denjhang/My4TH-light/README.md

# My4TH light
 My4TH light is the big brother of the My4TH XS computer board. In contrast to the My4TH XS it has an I2C interface that is 8 times faster than the I2C interface of the original My4TH board.   
 Originated from: http://mynor.org/my4th_xs.htm
