denjhang/My4TH-light/schematics_my4th-light_v1.2.pdf

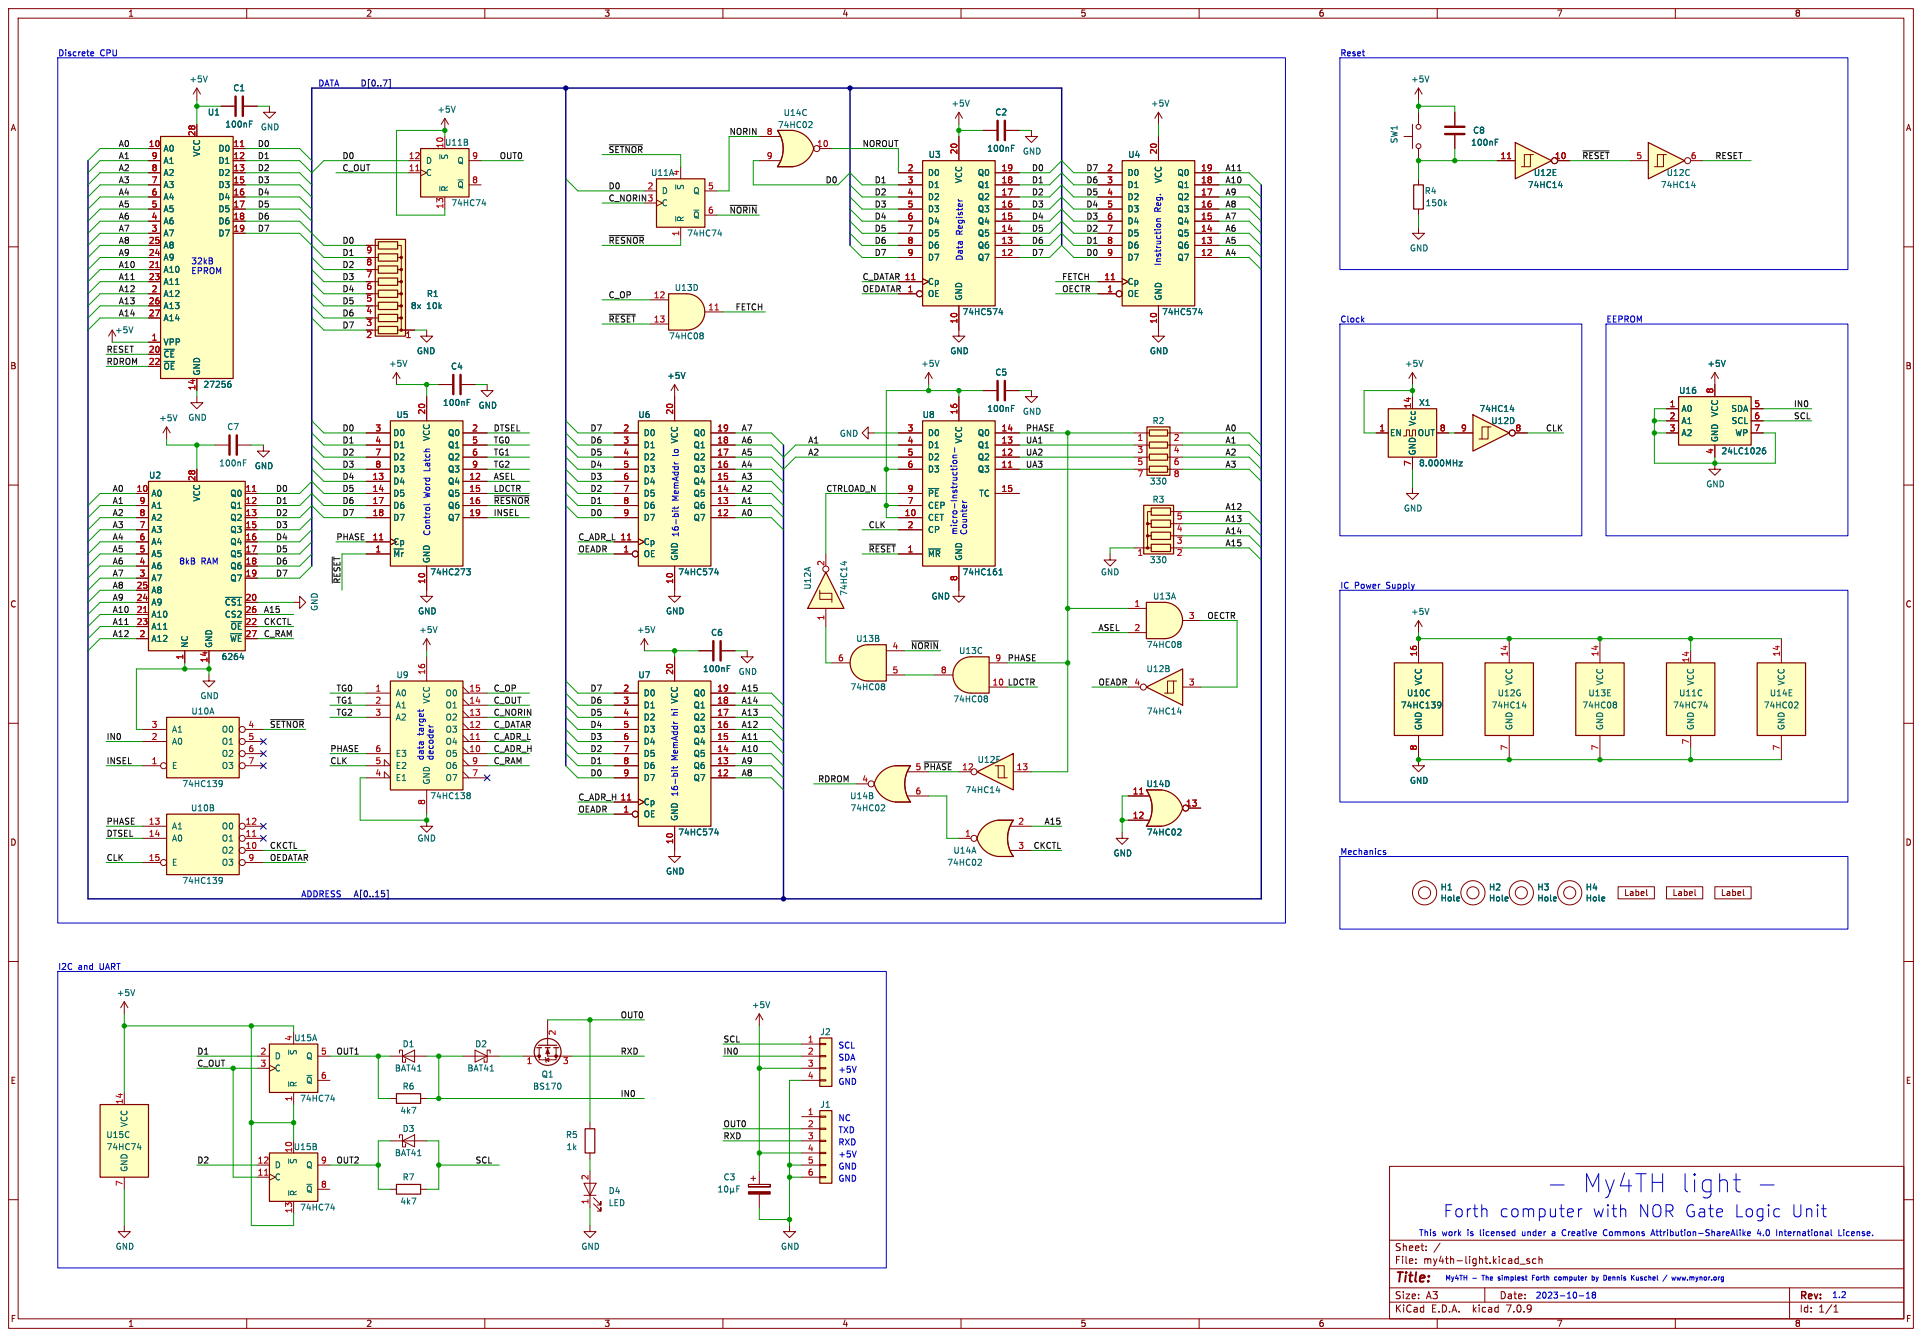
[picture p24: page 1]

D3 16-bit MemAddr hi
1.2 Data Register SCL 16-bit MemAddr lo

IC Power Supply 8kB RAM

Id: 1/1 Title: File: my4th-light.kicad_sch Sheet: /
