denjhang/My4TH-light/kicad_my4th-light_v1.2/kicad_my4th-light_v1.2/my4th-light.kicad_pcb

## KiCad design kicad_my4th-light_v1.2/kicad_my4th-light_v1.2/my4th-light.kicad_pcb (2024-05-02)

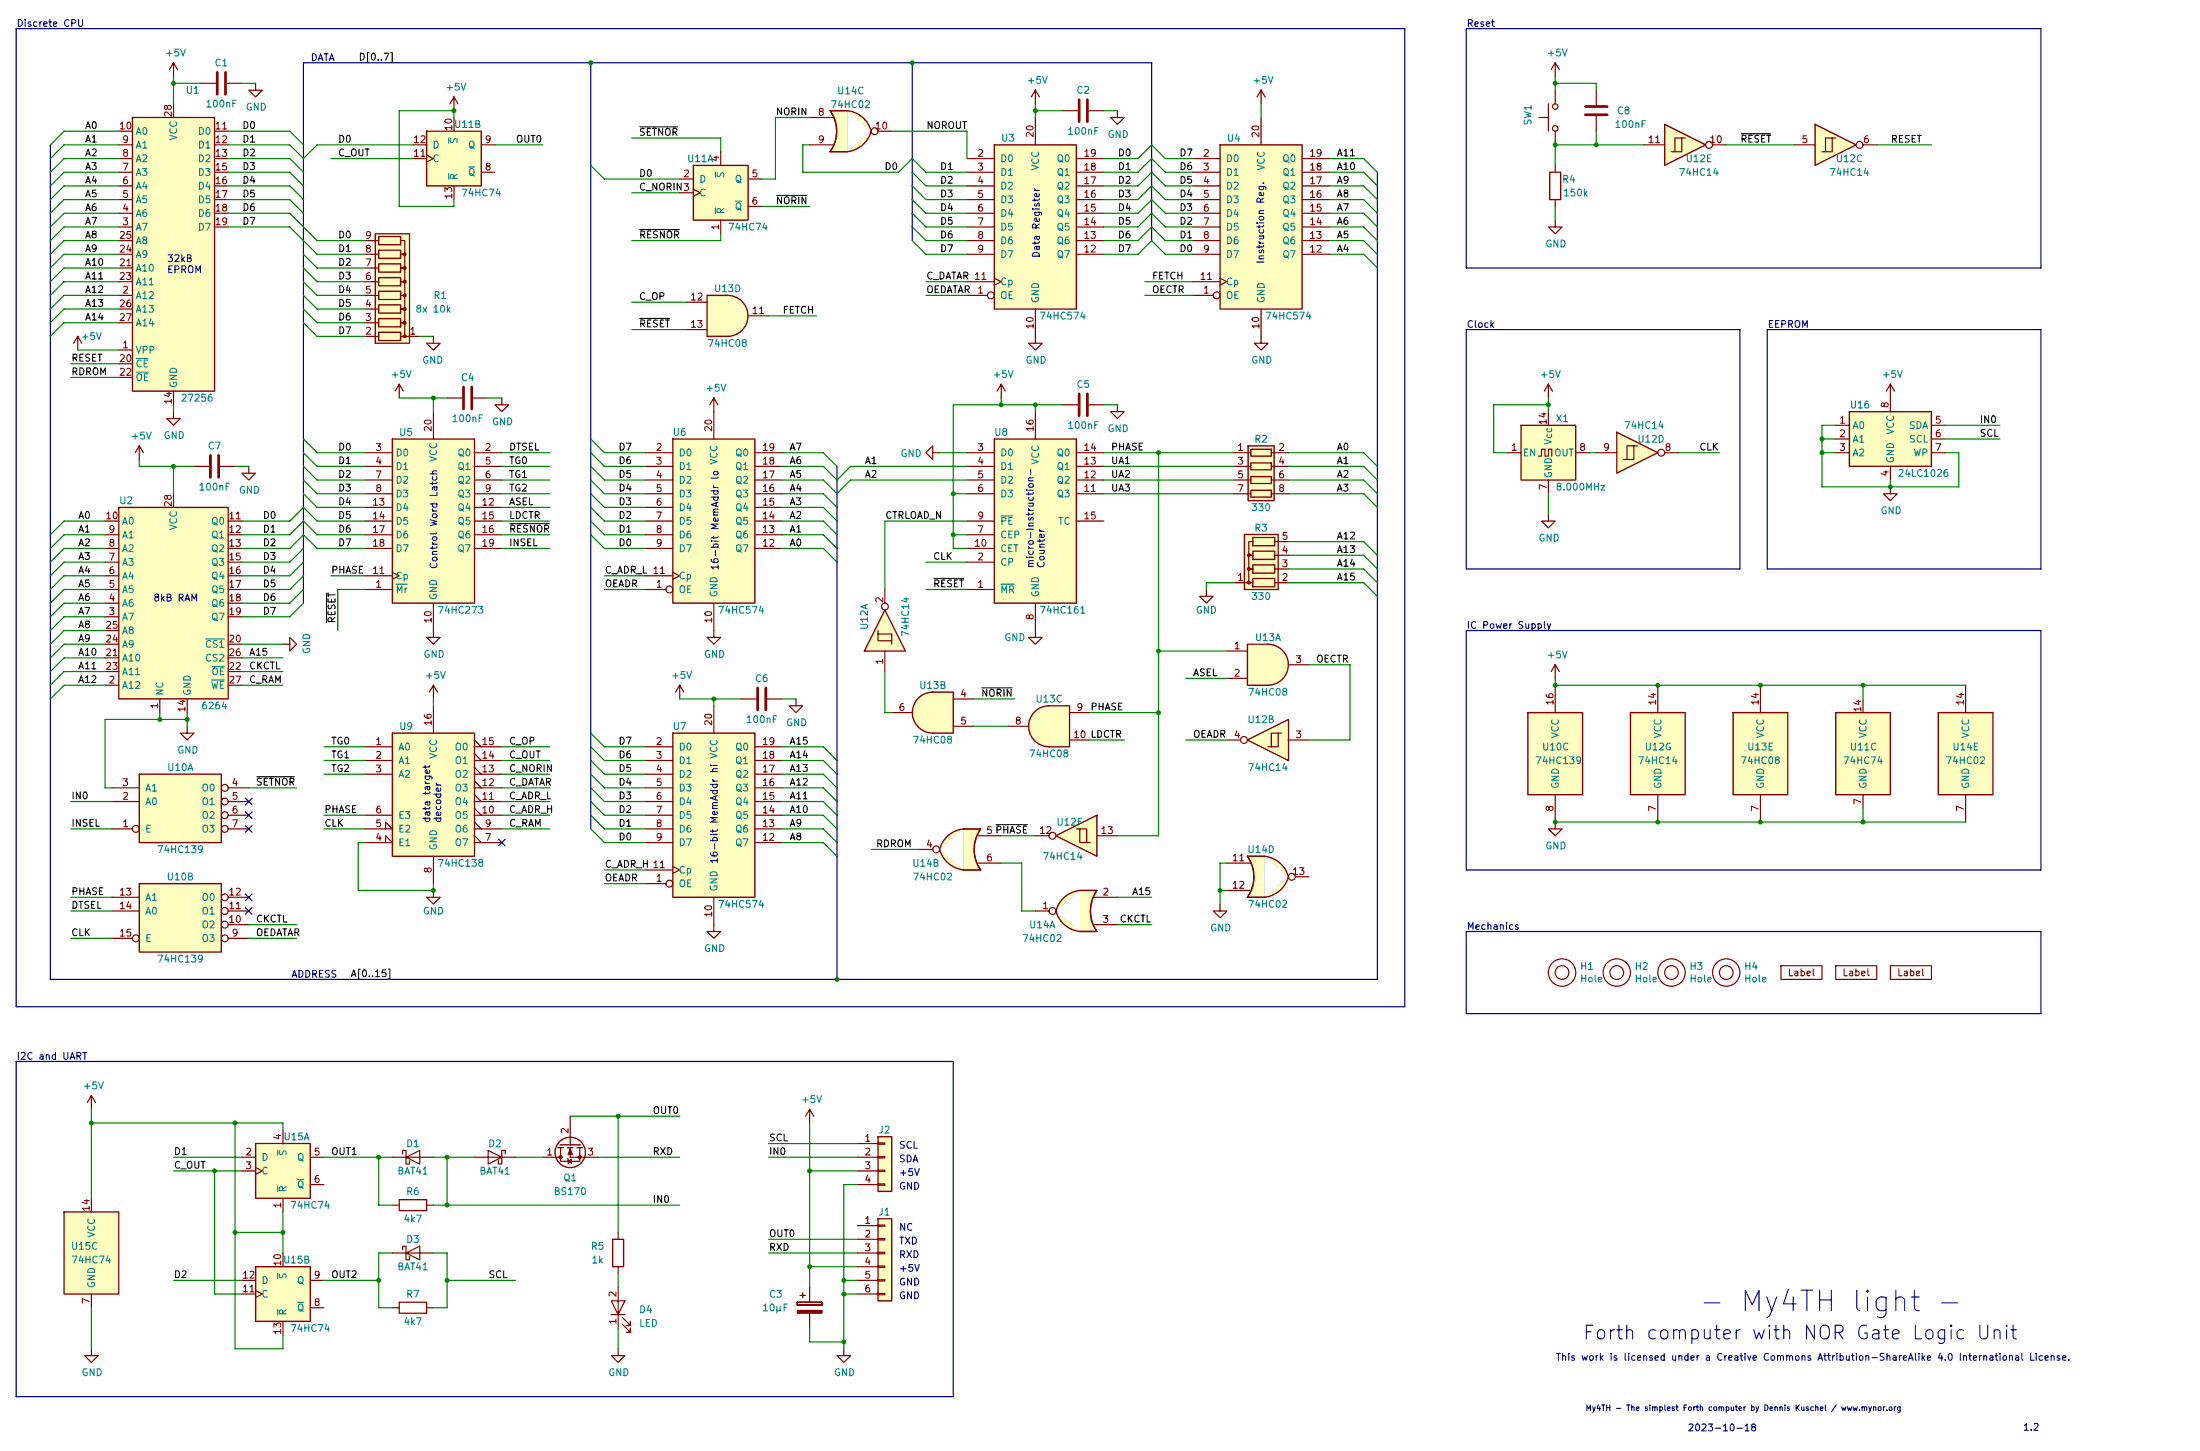
[picture p25: schematic my4th-light.kicad_sch]

Parts:
C1, C2, C4, C5, C6, C7, C8: 100nF; C_Disc_D5.0mm_W2.5mm_P5.00mm
C3: 10µF; CP_Radial_D5.0mm_P2.00mm
D1, D2, D3: BAT41; D_DO-35_SOD27_P7.62mm_Horizontal
D4: LED; LED_D3.0mm
H1, H2, H3, H4: Hole; nonplated_hole_drill_2.6mm_dia_5.2mm
J1: Conn_01x06; Pin_Header_Angled_1x06_Pitch2.54mm
J2: Conn_01x04; Pin_Header_Angled_1x04_Pitch2.54mm
LB1: Label; MyNOR-Logo-2
LB2: Label; cc-by-sa
LB3: Label; img-my4th
Q1: BS170; TO-92_Inline_Wide
R1: 8x 10k; R_Array_SIP9
R2: 330; R_Array_SIP8
R3: 330; R_Array_SIP5
R4: 150k; R_Axial_DIN0207_L6.3mm_D2.5mm_P7.62mm_Horizontal
R5: 1k; R_Axial_DIN0207_L6.3mm_D2.5mm_P7.62mm_Horizontal
R6, R7: 4k7; R_Axial_DIN0207_L6.3mm_D2.5mm_P7.62mm_Horizontal
SW1: SW_Push; SW_PUSH_6mm_h4.3mm
U1: 27256; DIP-28_W15.24mm_Socket
U2: 6264; DIP-28_W15.24mm
U3, U4, U6, U7: 74HC574; DIP-20_W7.62mm
U5: 74HC273; DIP-20_W7.62mm
U8: 74HC161; DIP-16_W7.62mm
U9: 74HC138; DIP-16_W7.62mm
U10: 74HC139; DIP-16_W7.62mm
U11, U15: 74HC74; DIP-14_W7.62mm
U12: 74HC14; DIP-14_W7.62mm
U13: 74HC08; DIP-14_W7.62mm
U14: 74HC02; DIP-14_W7.62mm
U16: 24LC1026; DIP-8_W7.62mm
X1: 8.000MHz; Osc_DIP8_DIP14_LargePads

Connections:
+5V: C1.2, C2.2, C3.1, C4.2, C5.2, C6.2, C7.2, C8.2, J1.4, J2.3, SW1.2, U1.1 (VPP), U1.28 (VCC), U2.28 (VCC), U3.20 (VCC), U4.20 (VCC), U5.20 (VCC), U6.20 (VCC), U7.20 (VCC), U8.6 (D3), U8.7 (CEP), U8.10 (CET), U8.16 (VCC), U9.16 (VCC), U10.16 (VCC), U11.10 (~S), U11.13 (~R), U11.14 (VCC), U12.14 (VCC), U13.14 (VCC), U14.14 (VCC), U15.1 (~R), U15.4 (~S), U15.10 (~S), U15.13 (~R), U15.14 (VCC), U16.8 (VCC), X1.1 (EN), X1.14 (Vcc)
/A0: R2.2 (R1.2), U1.10 (A0), U2.10 (A0), U6.12 (Q7)
/A1: R2.4 (R2.2), U1.9 (A1), U2.9 (A1), U6.13 (Q6), U8.4 (D1)
/A2: R2.6 (R3.2), U1.8 (A2), U2.8 (A2), U6.14 (Q5), U8.5 (D2)
/A3: R2.8 (R4.2), U1.7 (A3), U2.7 (A3), U6.15 (Q4)
/A4: U1.6 (A4), U2.6 (A4), U4.12 (Q7), U6.16 (Q3)
/A5: U1.5 (A5), U2.5 (A5), U4.13 (Q6), U6.17 (Q2)
/A6: U1.4 (A6), U2.4 (A6), U4.14 (Q5), U6.18 (Q1)
/A7: U1.3 (A7), U2.3 (A7), U4.15 (Q4), U6.19 (Q0)
/A8: U1.25 (A8), U2.25 (A8), U4.16 (Q3), U7.12 (Q7)
/A9: U1.24 (A9), U2.24 (A9), U4.17 (Q2), U7.13 (Q6)
/A10: U1.21 (A10), U2.21 (A10), U4.18 (Q1), U7.14 (Q5)
/A11: U1.23 (A11), U2.23 (A11), U4.19 (Q0), U7.15 (Q4)
/A12: R3.5 (R4), U1.2 (A12), U2.2 (A12), U7.16 (Q3)
/A13: R3.4 (R3), U1.26 (A13), U7.17 (Q2)
/A14: R3.3 (R2), U1.27 (A14), U7.18 (Q1)
/A15: R3.2 (R1), U2.26 (CS2), U7.19 (Q0), U14.2
/ASEL: U5.12 (Q4), U13.2
/CKCTL: U2.22 (~OE), U10.10 (O2), U14.3
/CLK: U8.2 (CP), U9.5 (E2), U10.15 (E), U12.8
/CTRLOAD_N: U8.9 (~PE), U12.2
/C_ADR_H: U7.11 (Cp), U9.10 (O5)
/C_ADR_L: U6.11 (Cp), U9.11 (O4)
/C_DATAR: U3.11 (Cp), U9.12 (O3)
/C_NORIN: U9.13 (O2), U11.3 (C)
/C_OP: U9.15 (O0), U13.12
/C_OUT: U9.14 (O1), U11.11 (C), U15.3 (C), U15.11 (C)
/C_RAM: U2.27 (~WE), U9.9 (O6)
/D0: R1.9 (R8), U1.11 (D0), U2.11 (Q0), U3.19 (Q0), U4.9 (D7), U5.3 (D0), U6.9 (D7), U7.9 (D7), U11.2 (D), U11.12 (D), U14.9
/D1: R1.8 (R7), U1.12 (D1), U2.12 (Q1), U3.3 (D1), U3.18 (Q1), U4.8 (D6), U5.4 (D1), U6.8 (D6), U7.8 (D6), U15.2 (D)
/D2: R1.7 (R6), U1.13 (D2), U2.13 (Q2), U3.4 (D2), U3.17 (Q2), U4.7 (D5), U5.7 (D2), U6.7 (D5), U7.7 (D5), U15.12 (D)
/D3: R1.6 (R5), U1.15 (D3), U2.15 (Q3), U3.5 (D3), U3.16 (Q3), U4.6 (D4), U5.8 (D3), U6.6 (D4), U7.6 (D4)
/D4: R1.5 (R4), U1.16 (D4), U2.16 (Q4), U3.6 (D4), U3.15 (Q4), U4.5 (D3), U5.13 (D4), U6.5 (D3), U7.5 (D3)
/D5: R1.4 (R3), U1.17 (D5), U2.17 (Q5), U3.7 (D5), U3.14 (Q5), U4.4 (D2), U5.14 (D5), U6.4 (D2), U7.4 (D2)
/D6: R1.3 (R2), U1.18 (D6), U2.18 (Q6), U3.8 (D6), U3.13 (Q6), U4.3 (D1), U5.17 (D6), U6.3 (D1), U7.3 (D1)
/D7: R1.2 (R1), U1.19 (D7), U2.19 (Q7), U3.9 (D7), U3.12 (Q7), U4.2 (D0), U5.18 (D7), U6.2 (D0), U7.2 (D0)
/DTSEL: U5.2 (Q0), U10.14 (A0)
/FETCH: U4.11 (Cp), U13.11
/IN0: D1.2 (A), D2.2 (A), J2.2, R6.2, U10.2 (A0), U16.5 (SDA)
/INSEL: U5.19 (Q7), U10.1 (E)
/LDCTR: U5.15 (Q5), U13.10
/NORIN: U11.5 (Q), U14.8
/NOROUT: U3.2 (D0), U14.10
/OEADR: U6.1 (OE), U7.1 (OE), U12.4
/OECTR: U4.1 (OE), U12.3, U13.3
/OEDATAR: U3.1 (OE), U10.9 (O3)
/OUT0: J1.2, Q1.2 (G), R5.1, U11.9 (Q)
/OUT1: D1.1 (K), R6.1, U15.5 (Q)
/OUT2: D3.1 (K), R7.1, U15.9 (Q)
/PHASE: R2.1 (R1.1), U5.11 (Cp), U8.14 (Q0), U9.6 (E3), U10.13 (A1), U12.13, U13.1, U13.9
/RDROM: U1.22 (~OE), U14.4
/RESET: U1.20 (~CE), U12.6
/RXD: J1.3, Q1.3 (S)
/SCL: D3.2 (A), J2.1, R7.2, U16.6 (SCL)
/TG0: U5.5 (Q1), U9.1 (A0)
/TG1: U5.6 (Q2), U9.2 (A1)
/TG2: U5.9 (Q3), U9.3 (A2)
/UA1: R2.3 (R2.1), U8.13 (Q1)
/UA2: R2.5 (R3.1), U8.12 (Q2)
/UA3: R2.7 (R4.1), U8.11 (Q3)
/~NORIN: U11.6 (~Q), U13.4
/~PHASE: U12.12, U14.5
/~RESET: U5.1 (~Mr), U8.1 (~MR), U12.5, U12.10, U13.13
/~RESNOR: U5.16 (Q6), U11.1 (~R)
/~SETNOR: U10.4 (O0), U11.4 (~S)
GND: C1.1, C2.1, C3.2, C4.1, C5.1, C6.1, C7.1, D4.1 (K), J1.5, J1.6, J2.4, R1.1 (common), R3.1 (common), R4.2, U1.14 (GND), U2.1 (NC), U2.14 (GND), U2.20 (~CS1), U3.10 (GND), U4.10 (GND), U5.10 (GND), U6.10 (GND), U7.10 (GND), U8.3 (D0), U8.8 (GND), U9.4 (E1), U9.8 (GND), U10.3 (A1), U10.8 (GND), U11.7 (GND), U12.7 (GND), U13.7 (GND), U14.7 (GND), U14.11, U14.12, U15.7 (GND), U16.1 (A0), U16.2 (A1), U16.3 (A2), U16.4 (GND), U16.7 (WP), X1.7 (GND)
unnamed: C8.1, R4.1, SW1.1, U12.11
unnamed: D2.1 (K), Q1.1 (D)
unnamed: D4.2 (A), R5.2
unnamed: U12.1, U13.6
unnamed: U13.5, U13.8
unnamed: U14.1, U14.6
unnamed: U12.9, X1.8 (OUT)

Notes on the sheet:
Clock
EEPROM
SDA
Reset
Discrete CPU
data target decoder
DATA
+5V
My4TH - The simplest Forth computer by Dennis Kuschel / www.mynor.org
GND
RXD
Control Word Latch
16-bit MemAddr hi
2023-10-18
ADDRESS
16-bit MemAddr lo
- My4TH light -
IC Power Supply
TXD
1.2
Data Register
micro-Instruction- Counter
This work is licensed under a Creative Commons Attribution-ShareAlike 4.0 International License.
32kB EPROM
I2C and UART
Instruction Reg.
Mechanics
8kB RAM
SCL
Forth computer with NOR Gate Logic Unit

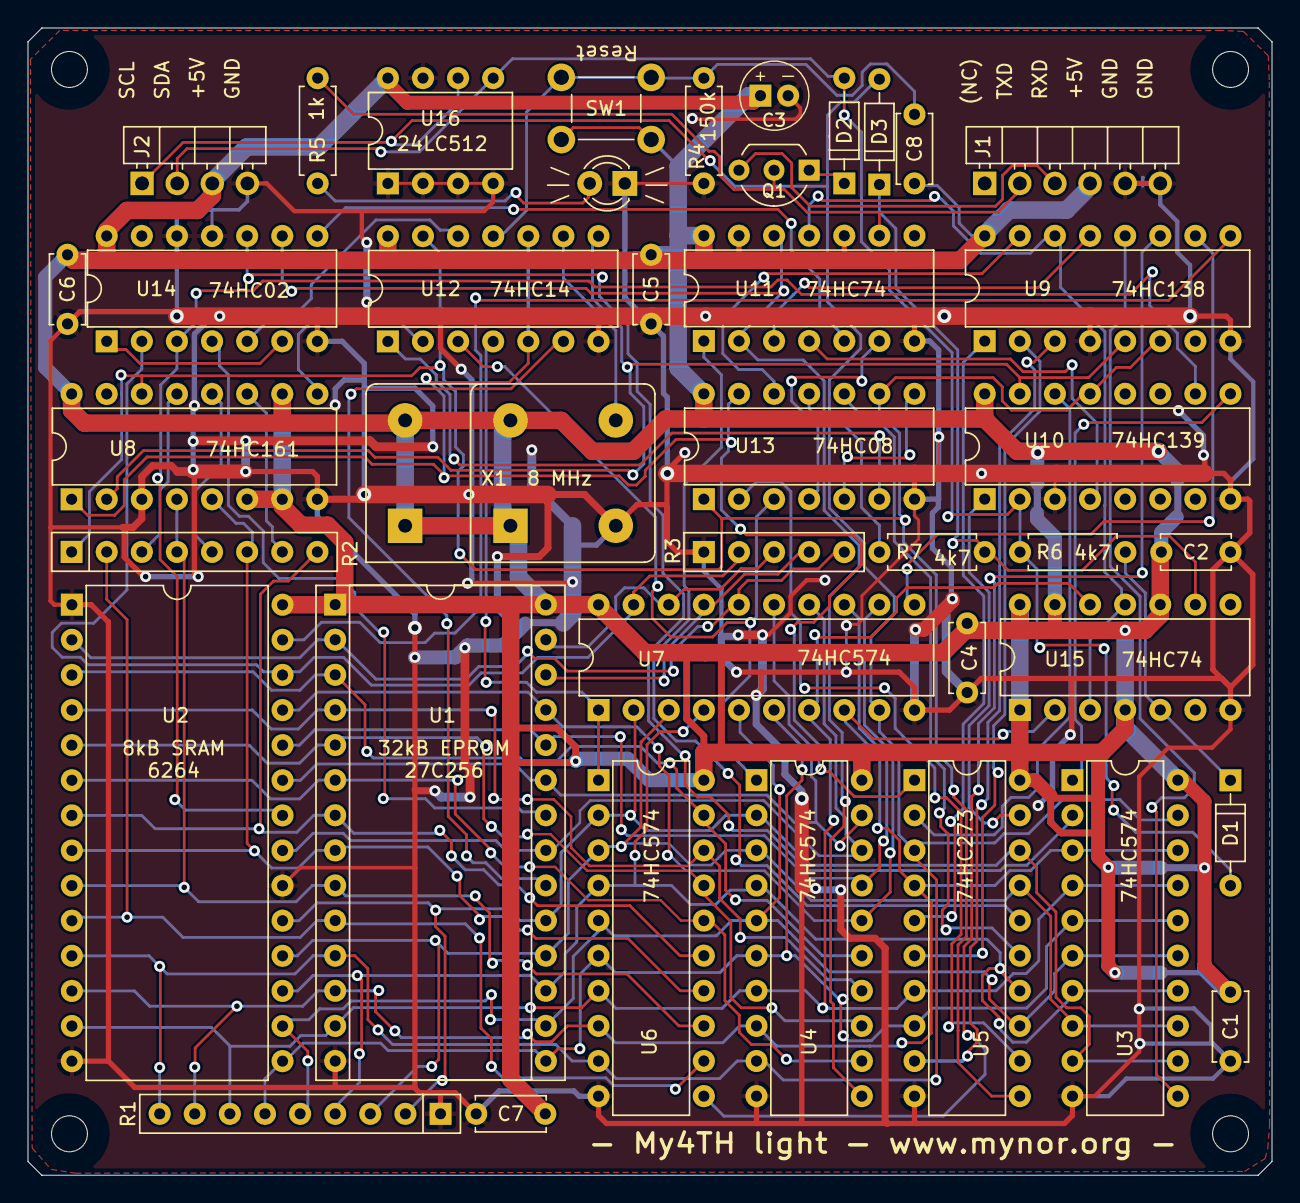
[picture p26: board my4th-light.kicad_pcb from above]

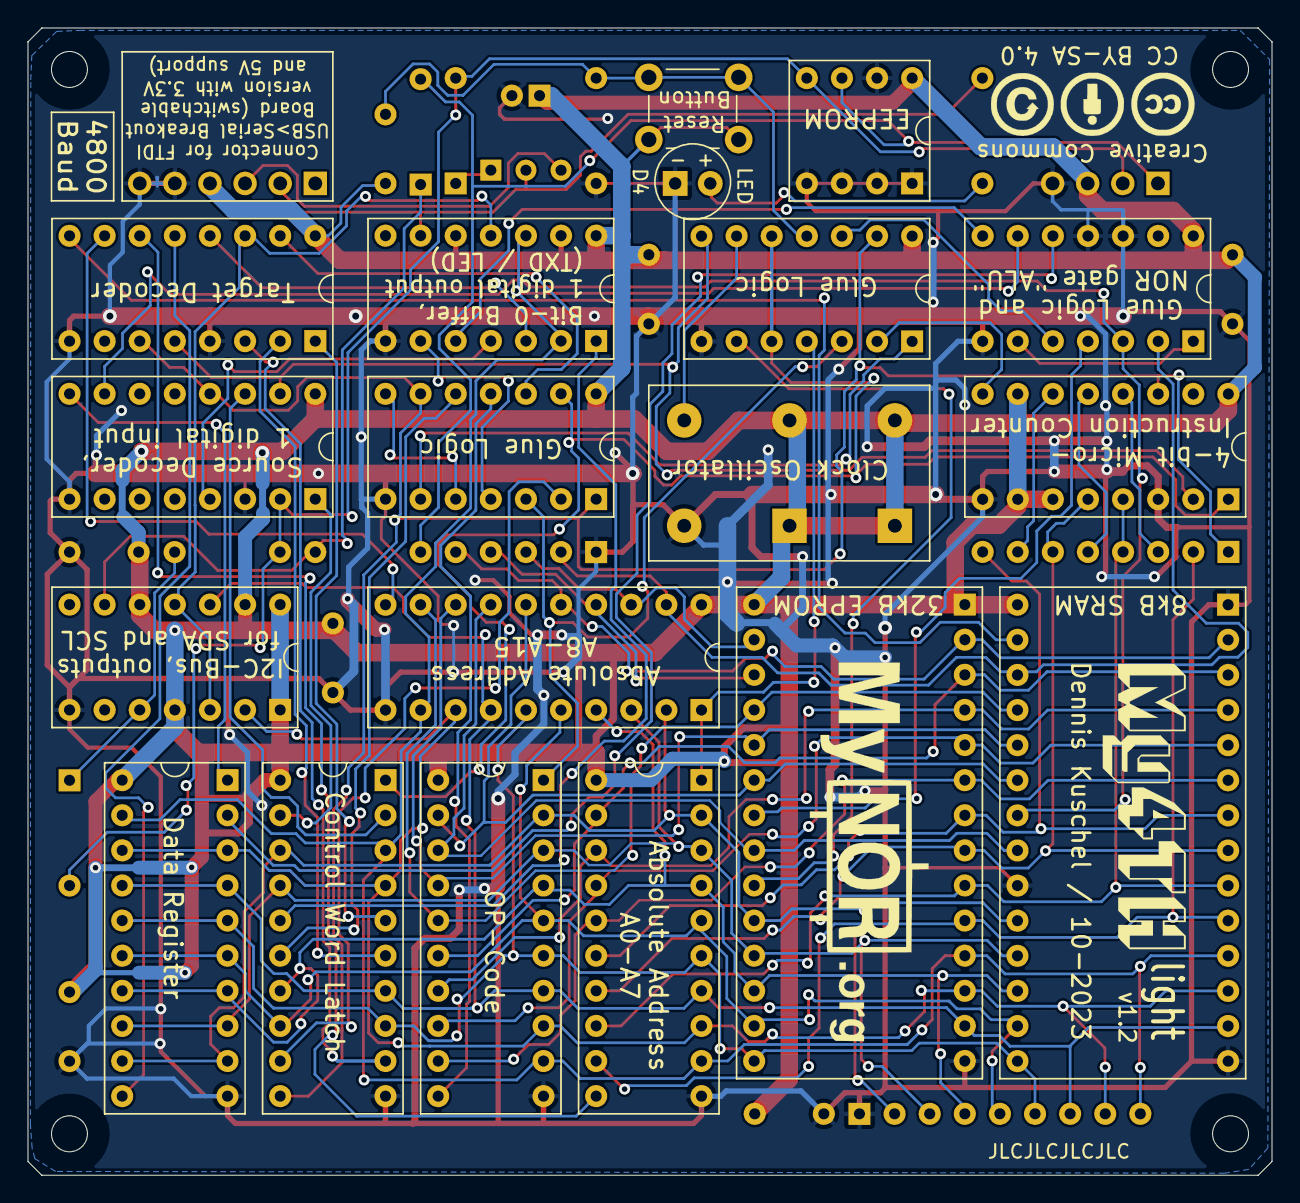
[picture p27: board my4th-light.kicad_pcb from below]

Board: 2 copper layers, 90.0 x 83.0 mm, 47 parts (3 on the bottom side), 73 nets.
