denjhang/My4TH-light/(notices)

Notices in the files:
kicad_my4th-light_v1.2/kicad_my4th-light_v1.2/my4th-light.kicad_pcb:
CC BY-SA 4.0
